technoblogy/minimal-rp2040-board/README.md

# Minimal RP2040 Board
Eagle files for a minimal breakout board based on the Raspberry Pi RP2040 processor.

See <http://www.technoblogy.com/show?3U75>.
